NicoDeebs/AutoUke/Media/20200423_194738.jpg

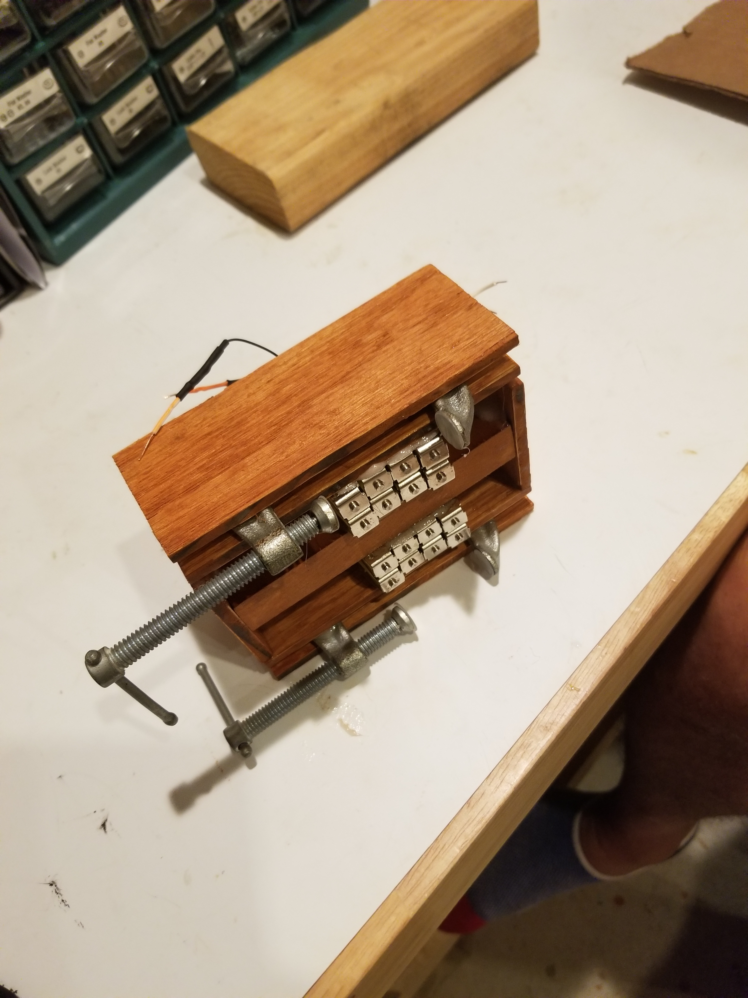
Media/20200423_194738.jpg
