NicoDeebs/AutoUke/Media/20200423_194740.jpg

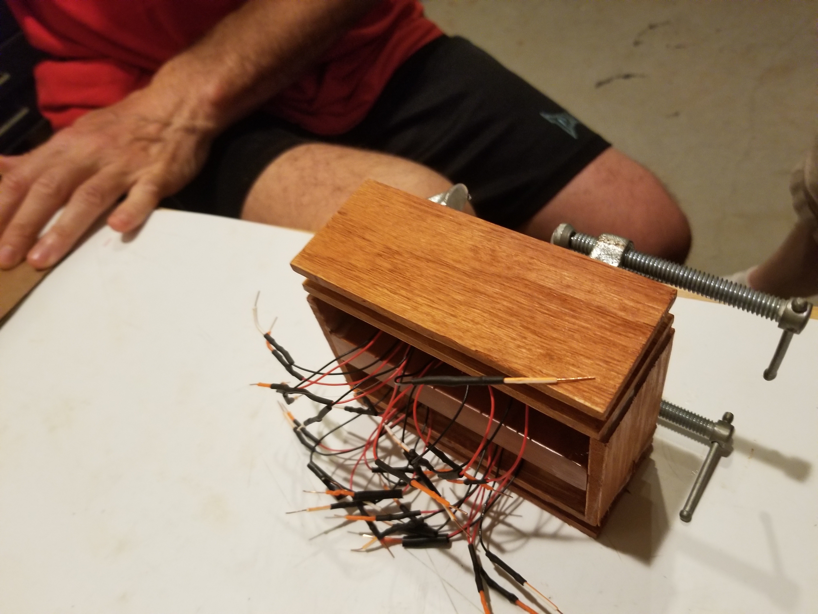
Media/20200423_194740.jpg
