NicoDeebs/AutoUke/Media/20200423_211323.jpg

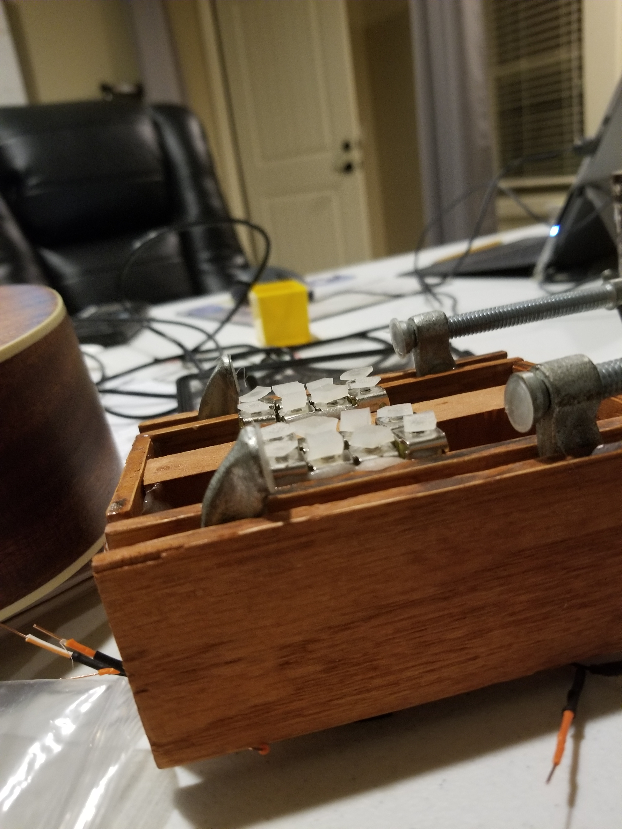
Media/20200423_211323.jpg
