NicoDeebs/AutoUke/Media/20200425_002207.jpg

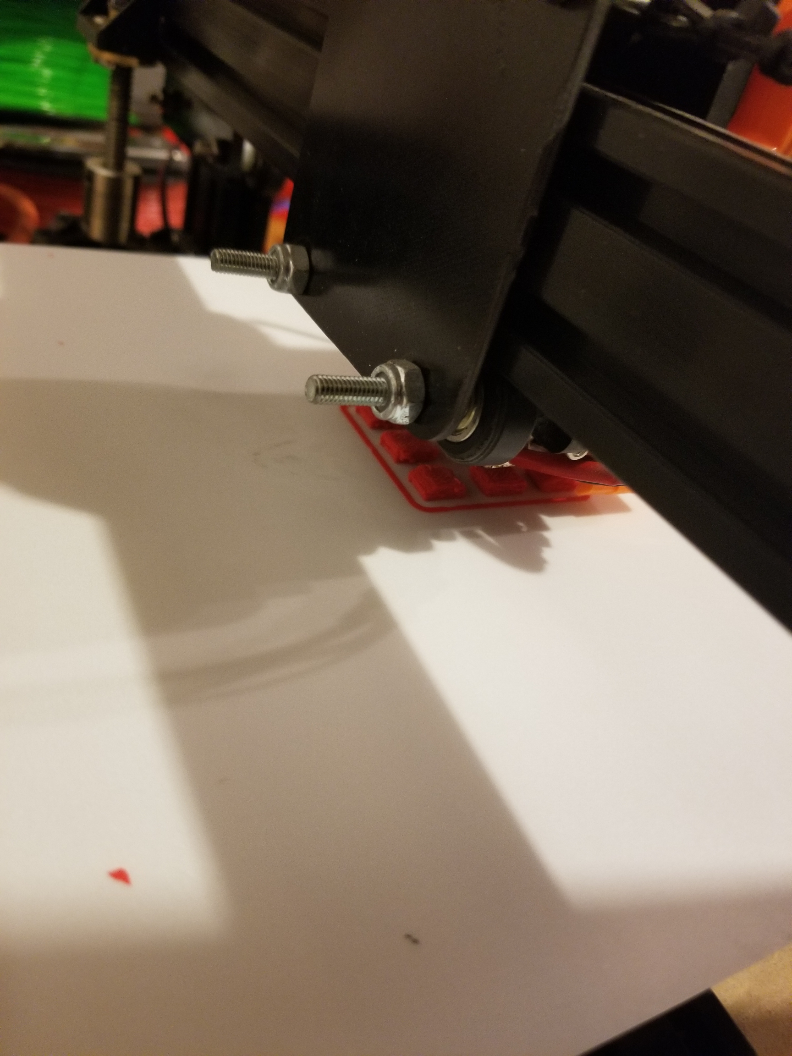
Media/20200425_002207.jpg
