NicoDeebs/AutoUke/Media/20200428_083730.jpg

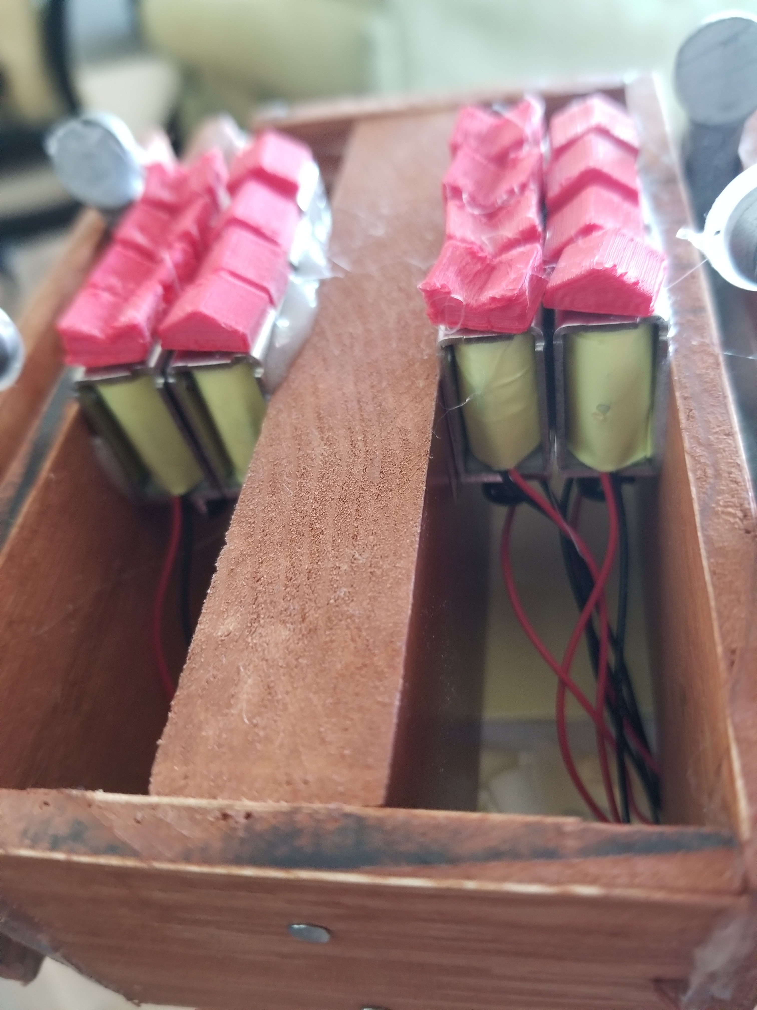
Media/20200428_083730.jpg
