NicoDeebs/AutoUke/Media/20200428_083743.jpg

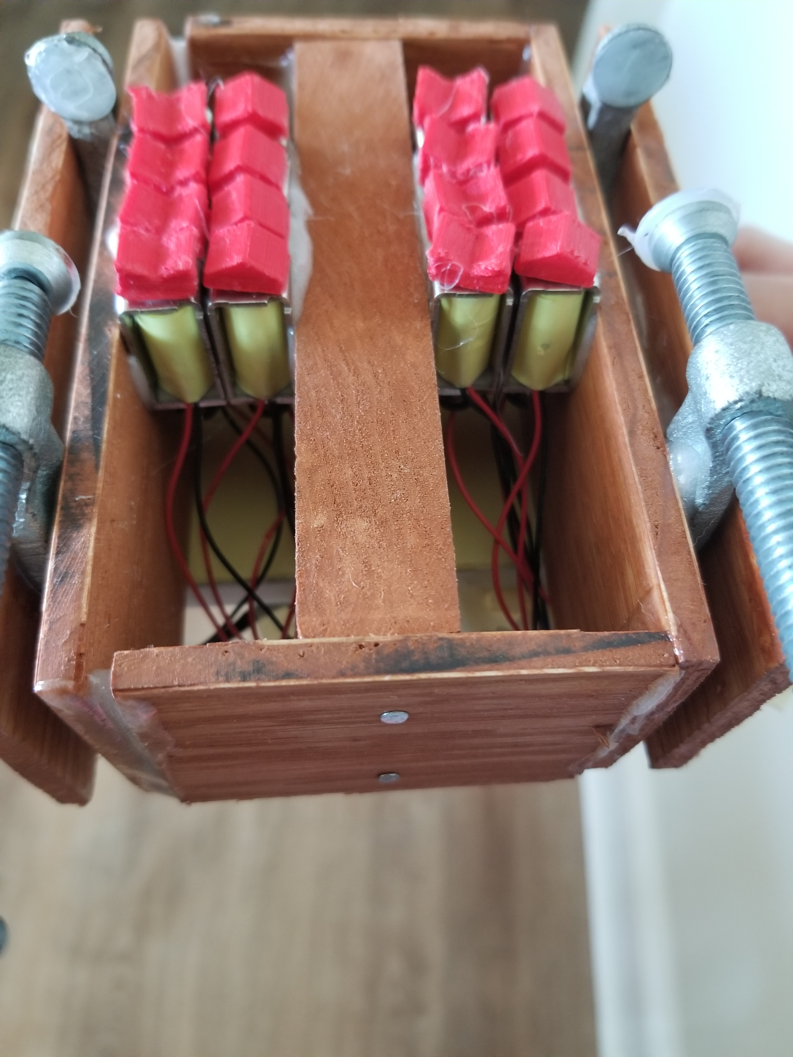
Media/20200428_083743.jpg
