NicoDeebs/AutoUke/Media/20200428_083903.jpg

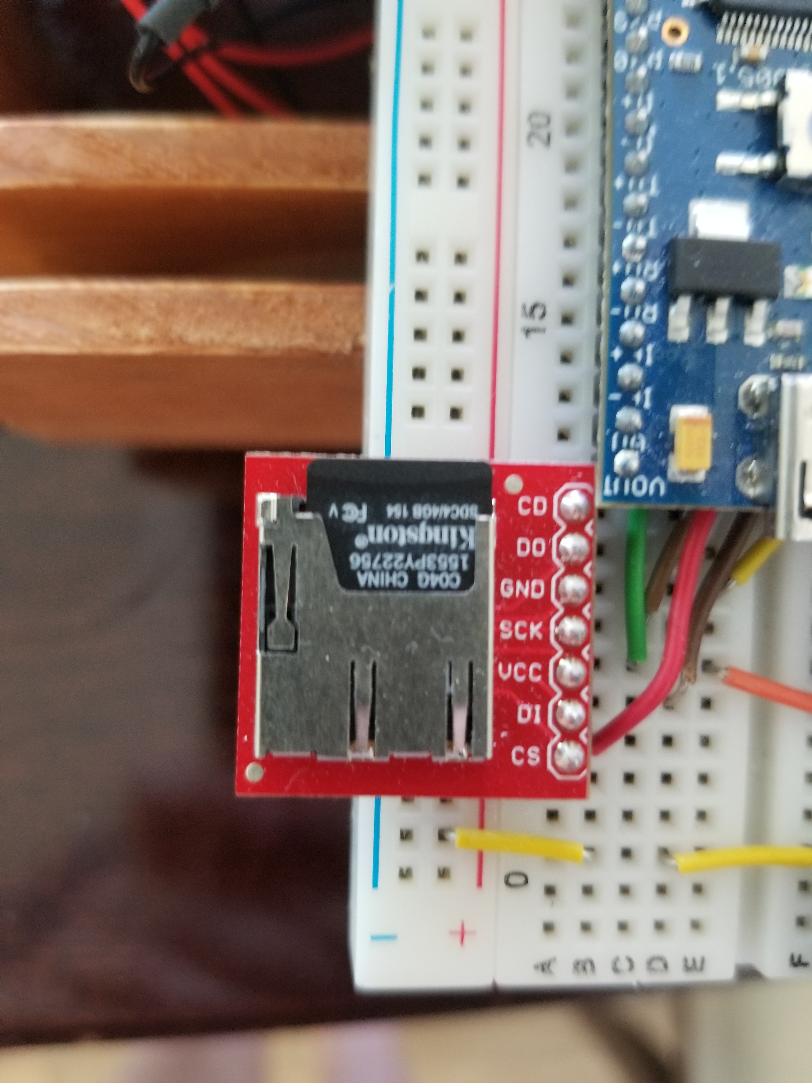
Media/20200428_083903.jpg
