NicoDeebs/AutoUke/Schematics/Autotouke Schematic.pdf

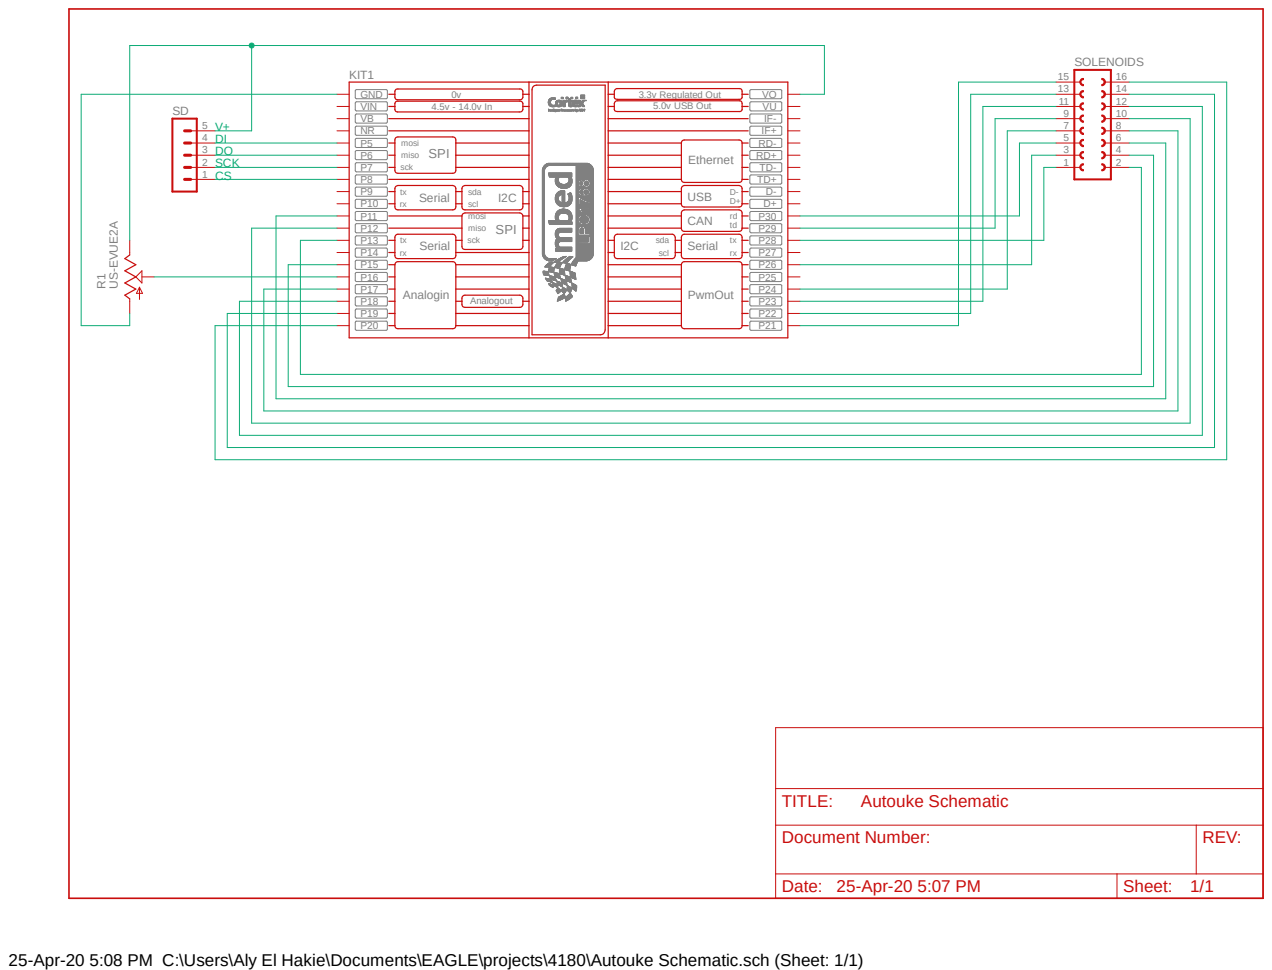
[picture p19: page 1]

3.3v Regulated Out 5.0v USB Out GND
VIN
VBNR

Document Number: | REV:

Date: 25-Apr-20 5:07 PM | Sheet: 1/1
