NicoDeebs/AutoUke/Schematics/Sol 1.pdf

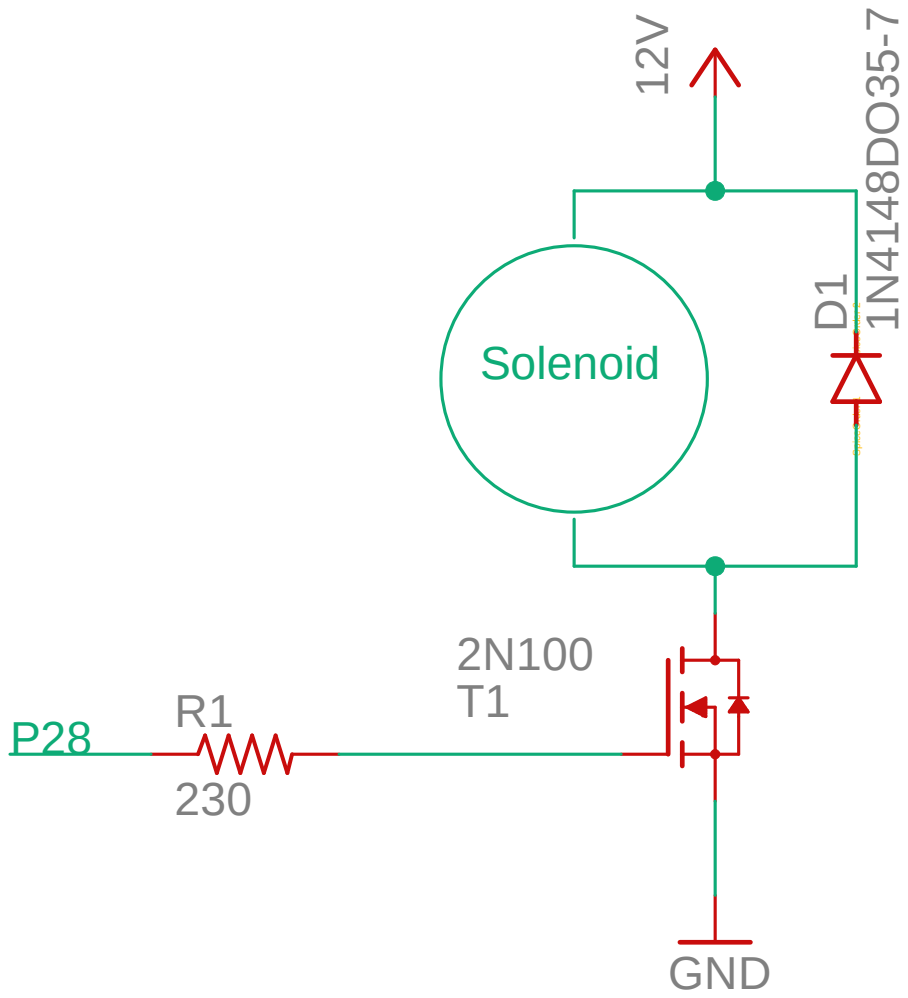
[picture p20: page 1]
GND ¹²V; TITLE:; Solenoid 1; Solenoid

25-Apr-20 5:08 PM C:\Users\Aly El Hakie\Documents\EAGLE\projects\4180\Solenoid 1.sch (Sheet: 1/1) SpiceOrder 1 SpiceOrder 2 1N⁴¹⁴⁸DO³⁵⁻⁷

Document Number: | REV:

Date: 25-Apr-20 4:13 PM | Sheet: 1/1
