NicoDeebs/AutoUke/Schematics/Autouke Schematic.sch

## EAGLE design Schematics/Autouke Schematic.sch (2020-04-27)

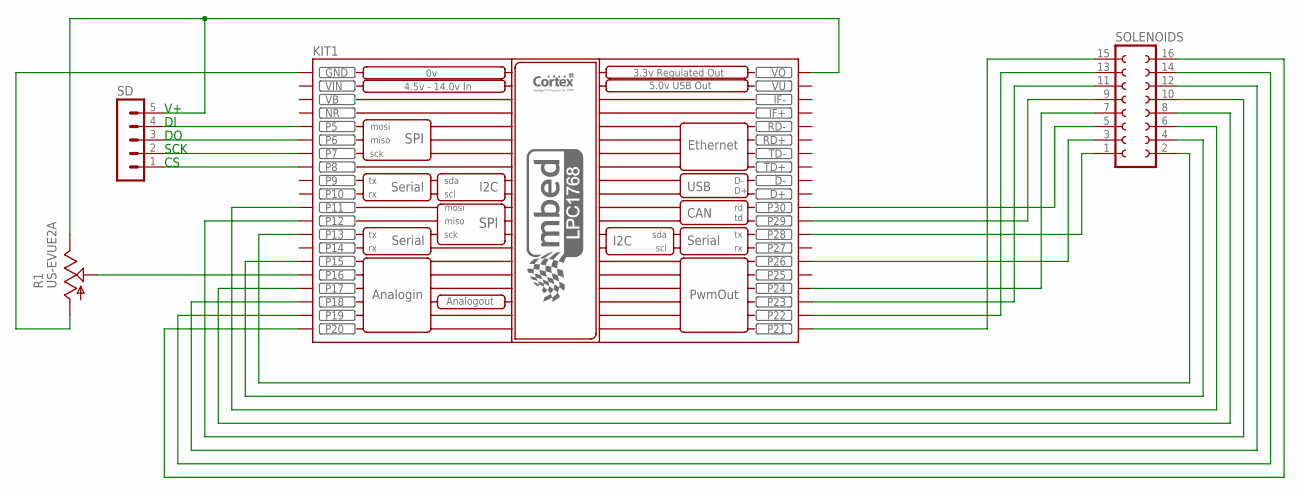
[picture p21: schematic Autouke Schematic.sch]

Parts:
KIT1: MBED_NXP_LPC1768; MBED-KIT
R1: US-EVUE2A; EVUE
SD: MA05-1
SOLENOIDS: FE08-2

Connections:
unnamed: KIT1.P$16 (P16), R1.2 (S)
unnamed: KIT1.VOUT (VO), R1.3 (E), SD.5
unnamed: KIT1.P$5 (P5), SD.4
unnamed: KIT1.P$6 (P6), SD.3
unnamed: KIT1.P$7 (P7), SD.2
unnamed: KIT1.P$8 (P8), SD.1
unnamed: KIT1.GND, R1.1 (A)
unnamed: KIT1.P$28 (P28), SOLENOIDS.1
unnamed: KIT1.P$13 (P13), SOLENOIDS.2
unnamed: KIT1.P$15 (P15), SOLENOIDS.4
unnamed: KIT1.P$26 (P26), SOLENOIDS.3
unnamed: KIT1.P$11 (P11), SOLENOIDS.6
unnamed: KIT1.P$24 (P24), SOLENOIDS.7
unnamed: KIT1.P$17 (P17), SOLENOIDS.8
unnamed: KIT1.P$29 (P29), SOLENOIDS.9
unnamed: KIT1.P$12 (P12), SOLENOIDS.10
unnamed: KIT1.P$23 (P23), SOLENOIDS.11
unnamed: KIT1.P$18 (P18), SOLENOIDS.12
unnamed: KIT1.P$22 (P22), SOLENOIDS.13
unnamed: KIT1.P$19 (P19), SOLENOIDS.14
unnamed: KIT1.P$21 (P21), SOLENOIDS.15
unnamed: KIT1.P$20 (P20), SOLENOIDS.16
unnamed: KIT1.P$30 (P30), SOLENOIDS.5

Notes on the sheet:
SCK
