NicoDeebs/AutoUke/Schematics/Solenoid 1.sch

## EAGLE design Schematics/Solenoid 1.sch (2020-04-27)

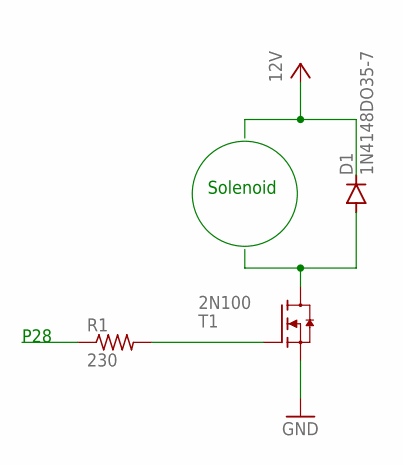
[picture p22: schematic Solenoid 1.sch]

Parts:
D1: 1N4148DO35-7; DO35-7
R1: 230; 0204/7
T1: 2N100; PG-TO263-7-3

Connections:
GND: T1.2 (S)
unnamed: R1.2, T1.1 (G)
unnamed: D1.A, T1.8 (D)
VCC: D1.C

Notes on the sheet:
Solenoid
P28
