NicoDeebs/AutoUke/Solenoids.h

//Location of the solenoids won't change.
//But their pin numbers might!
//This is to abstract that away from the main program.
#define sol1 p28
#define sol2 p13
#define sol3 p26
#define sol4 p15
#define sol5 p30
#define sol6 p11
#define sol7 p24
#define sol8 p17
#define sol9 p29
#define sol10 p12
#define sol11 p23
#define sol12 p18
#define sol13 p22
#define sol14 p19
#define sol15 p21
#define sol16 p20
