NicoDeebs/AutoUke/Media/20200423_200235.jpg

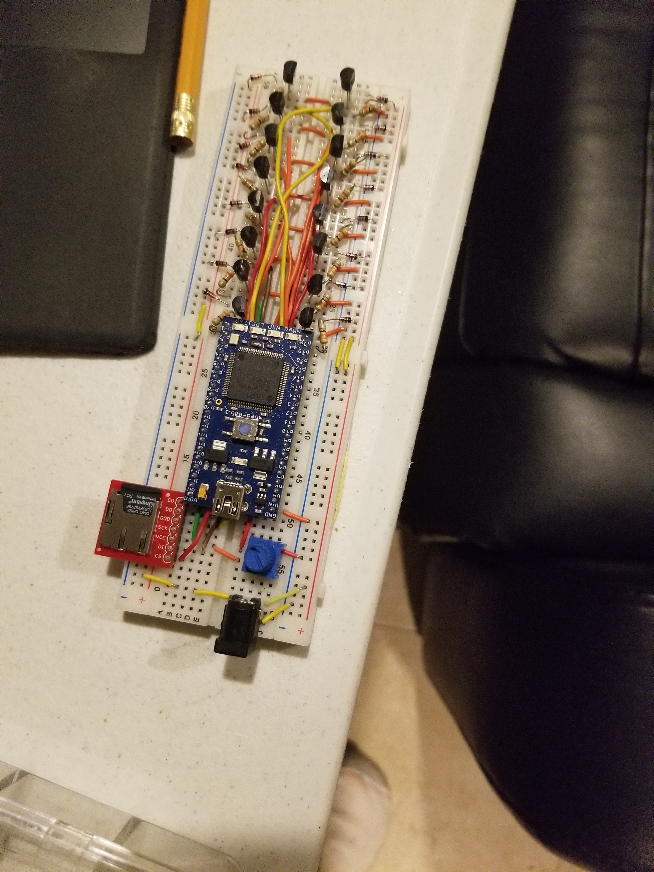
Media/20200423_200235.jpg
