NicoDeebs/AutoUke/Media/20200425_002226.jpg

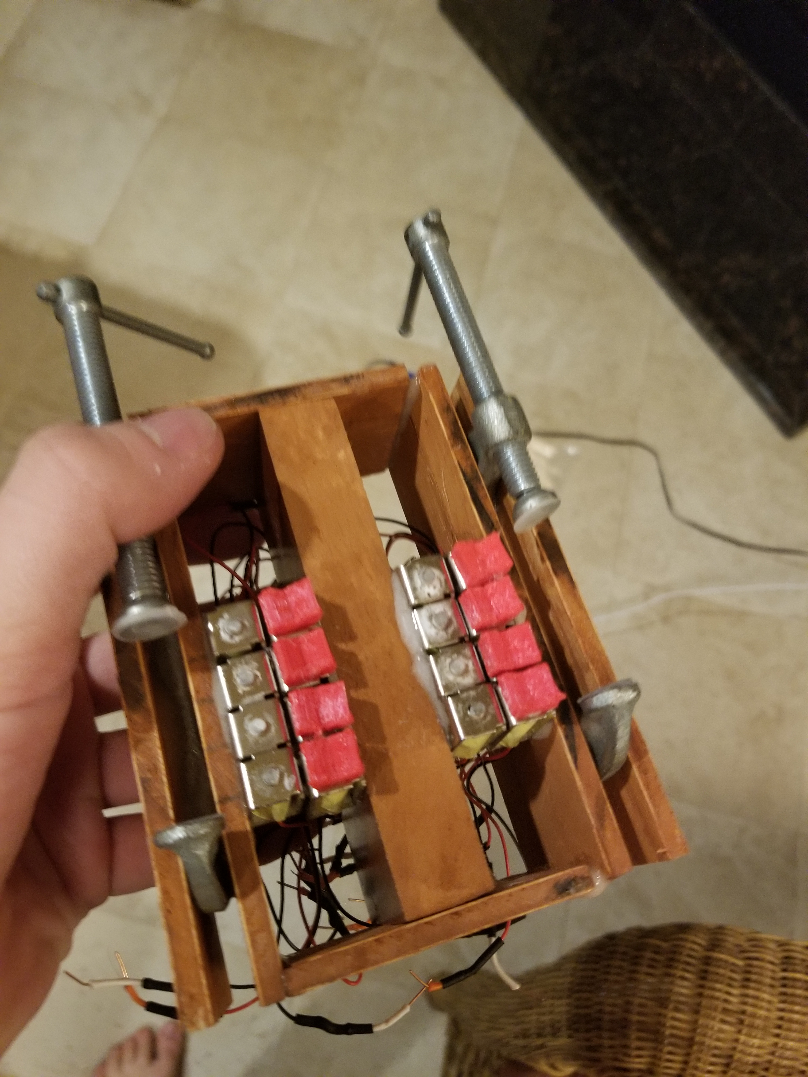
Media/20200425_002226.jpg
