NicoDeebs/AutoUke/Media/20200425_100150.jpg

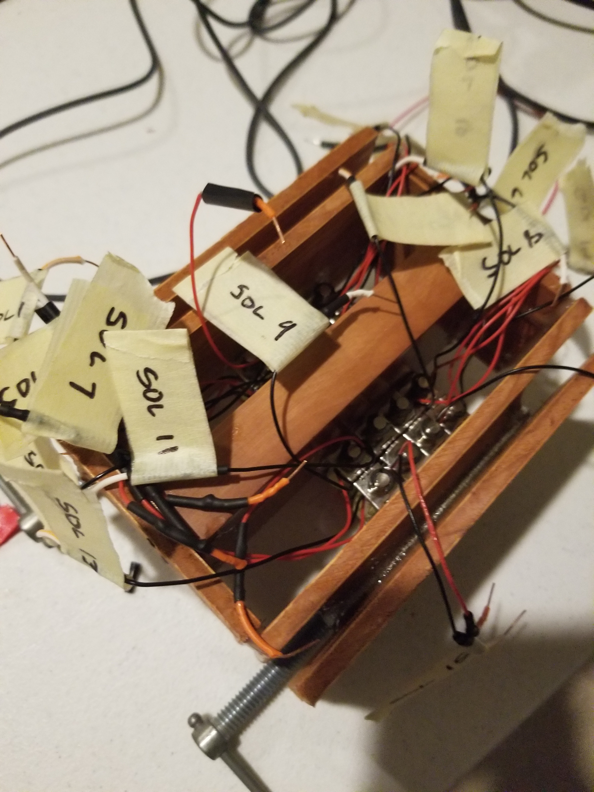
Media/20200425_100150.jpg
