NicoDeebs/AutoUke/Media/20200425_100153.jpg

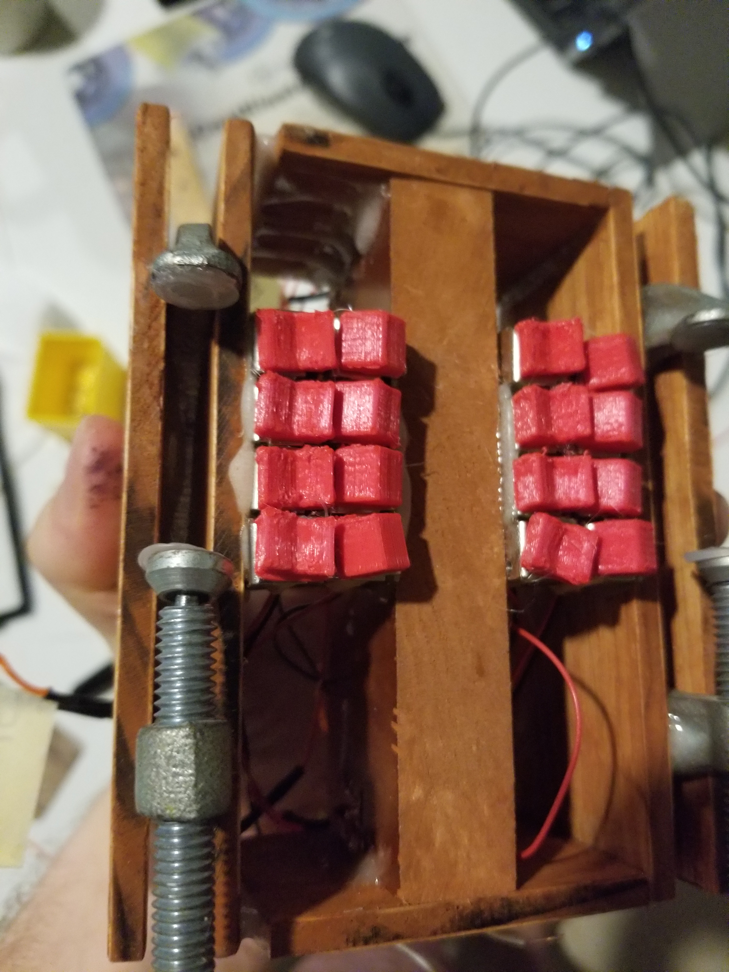
Media/20200425_100153.jpg
