NicoDeebs/AutoUke/Media/20200428_083843.jpg

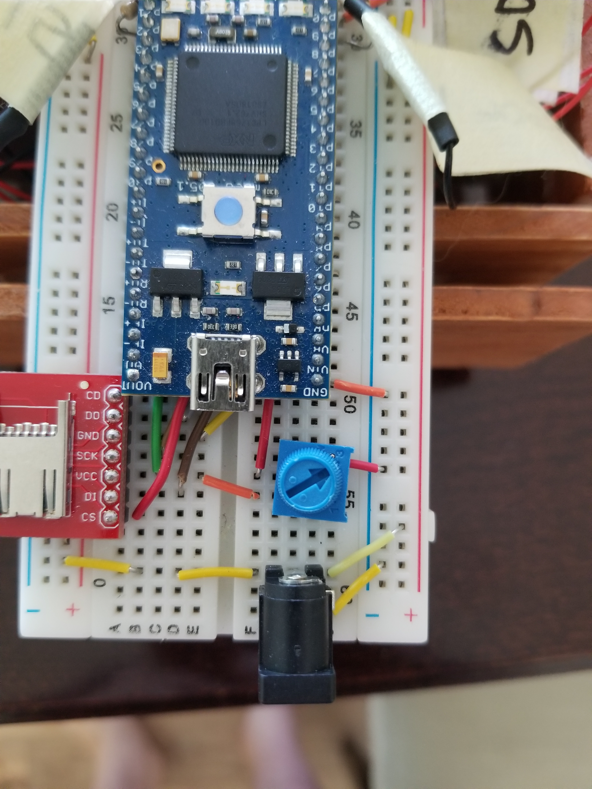
Media/20200428_083843.jpg
