NicoDeebs/AutoUke/Media/20200428_083912.jpg

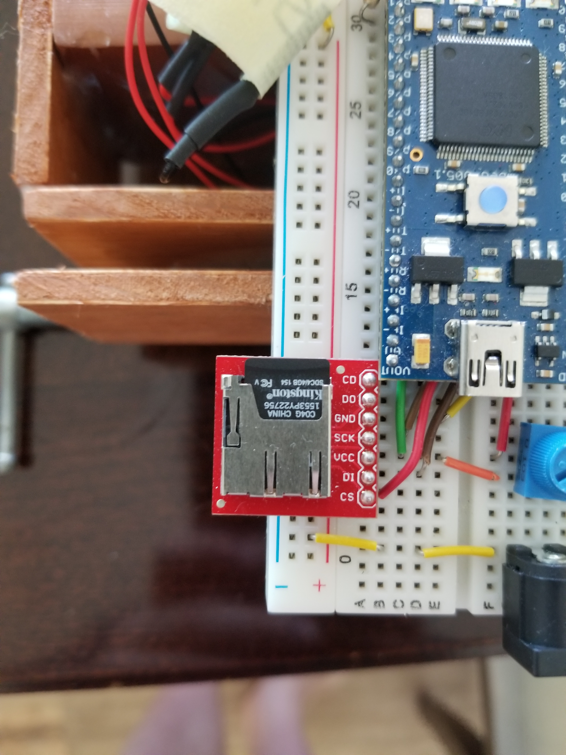
Media/20200428_083912.jpg
