NicoDeebs/AutoUke/Media/Switches.jpg

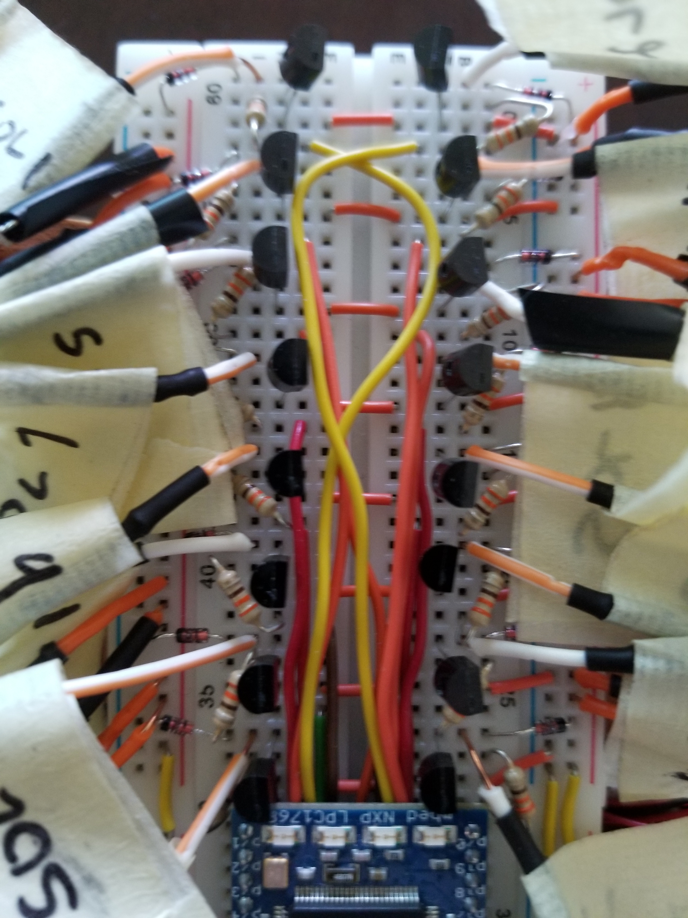
[picture p1: Media/Switches.jpg]
Media/Switches.jpg
