NicoDeebs/AutoUke/Media/Nobreadboard.jpg

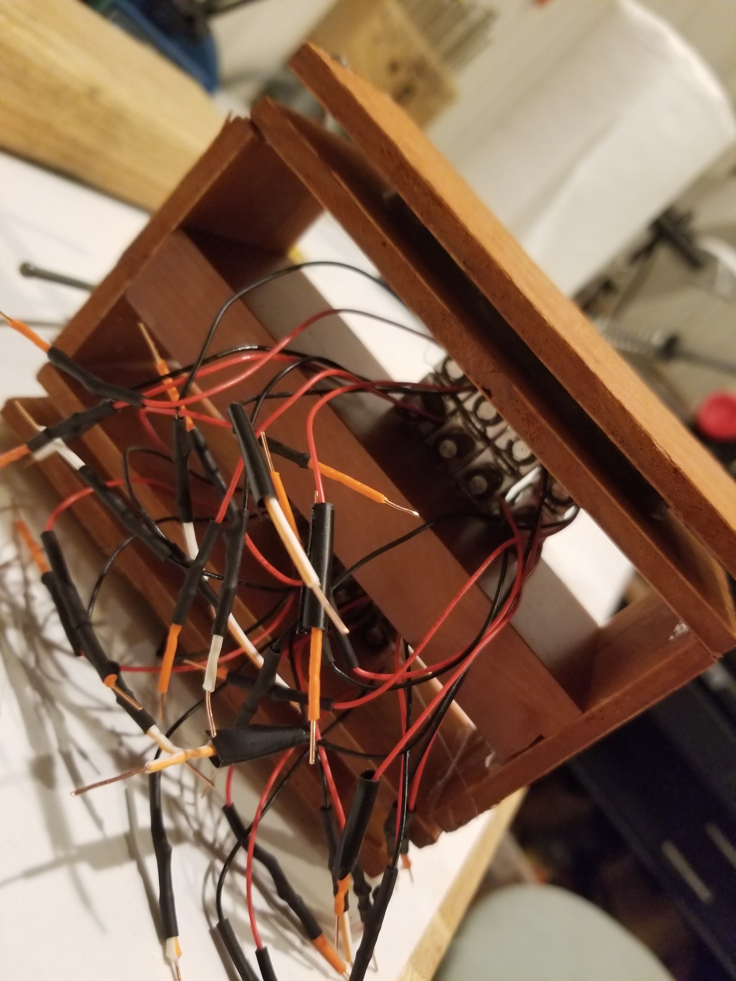
[picture p3: Media/Nobreadboard.jpg]
Media/Nobreadboard.jpg
